zachmorr/IMX6ULL-Dev-Board/Keychain.kicad_pcb

## KiCad design Keychain.kicad_pcb (2021-06-18)

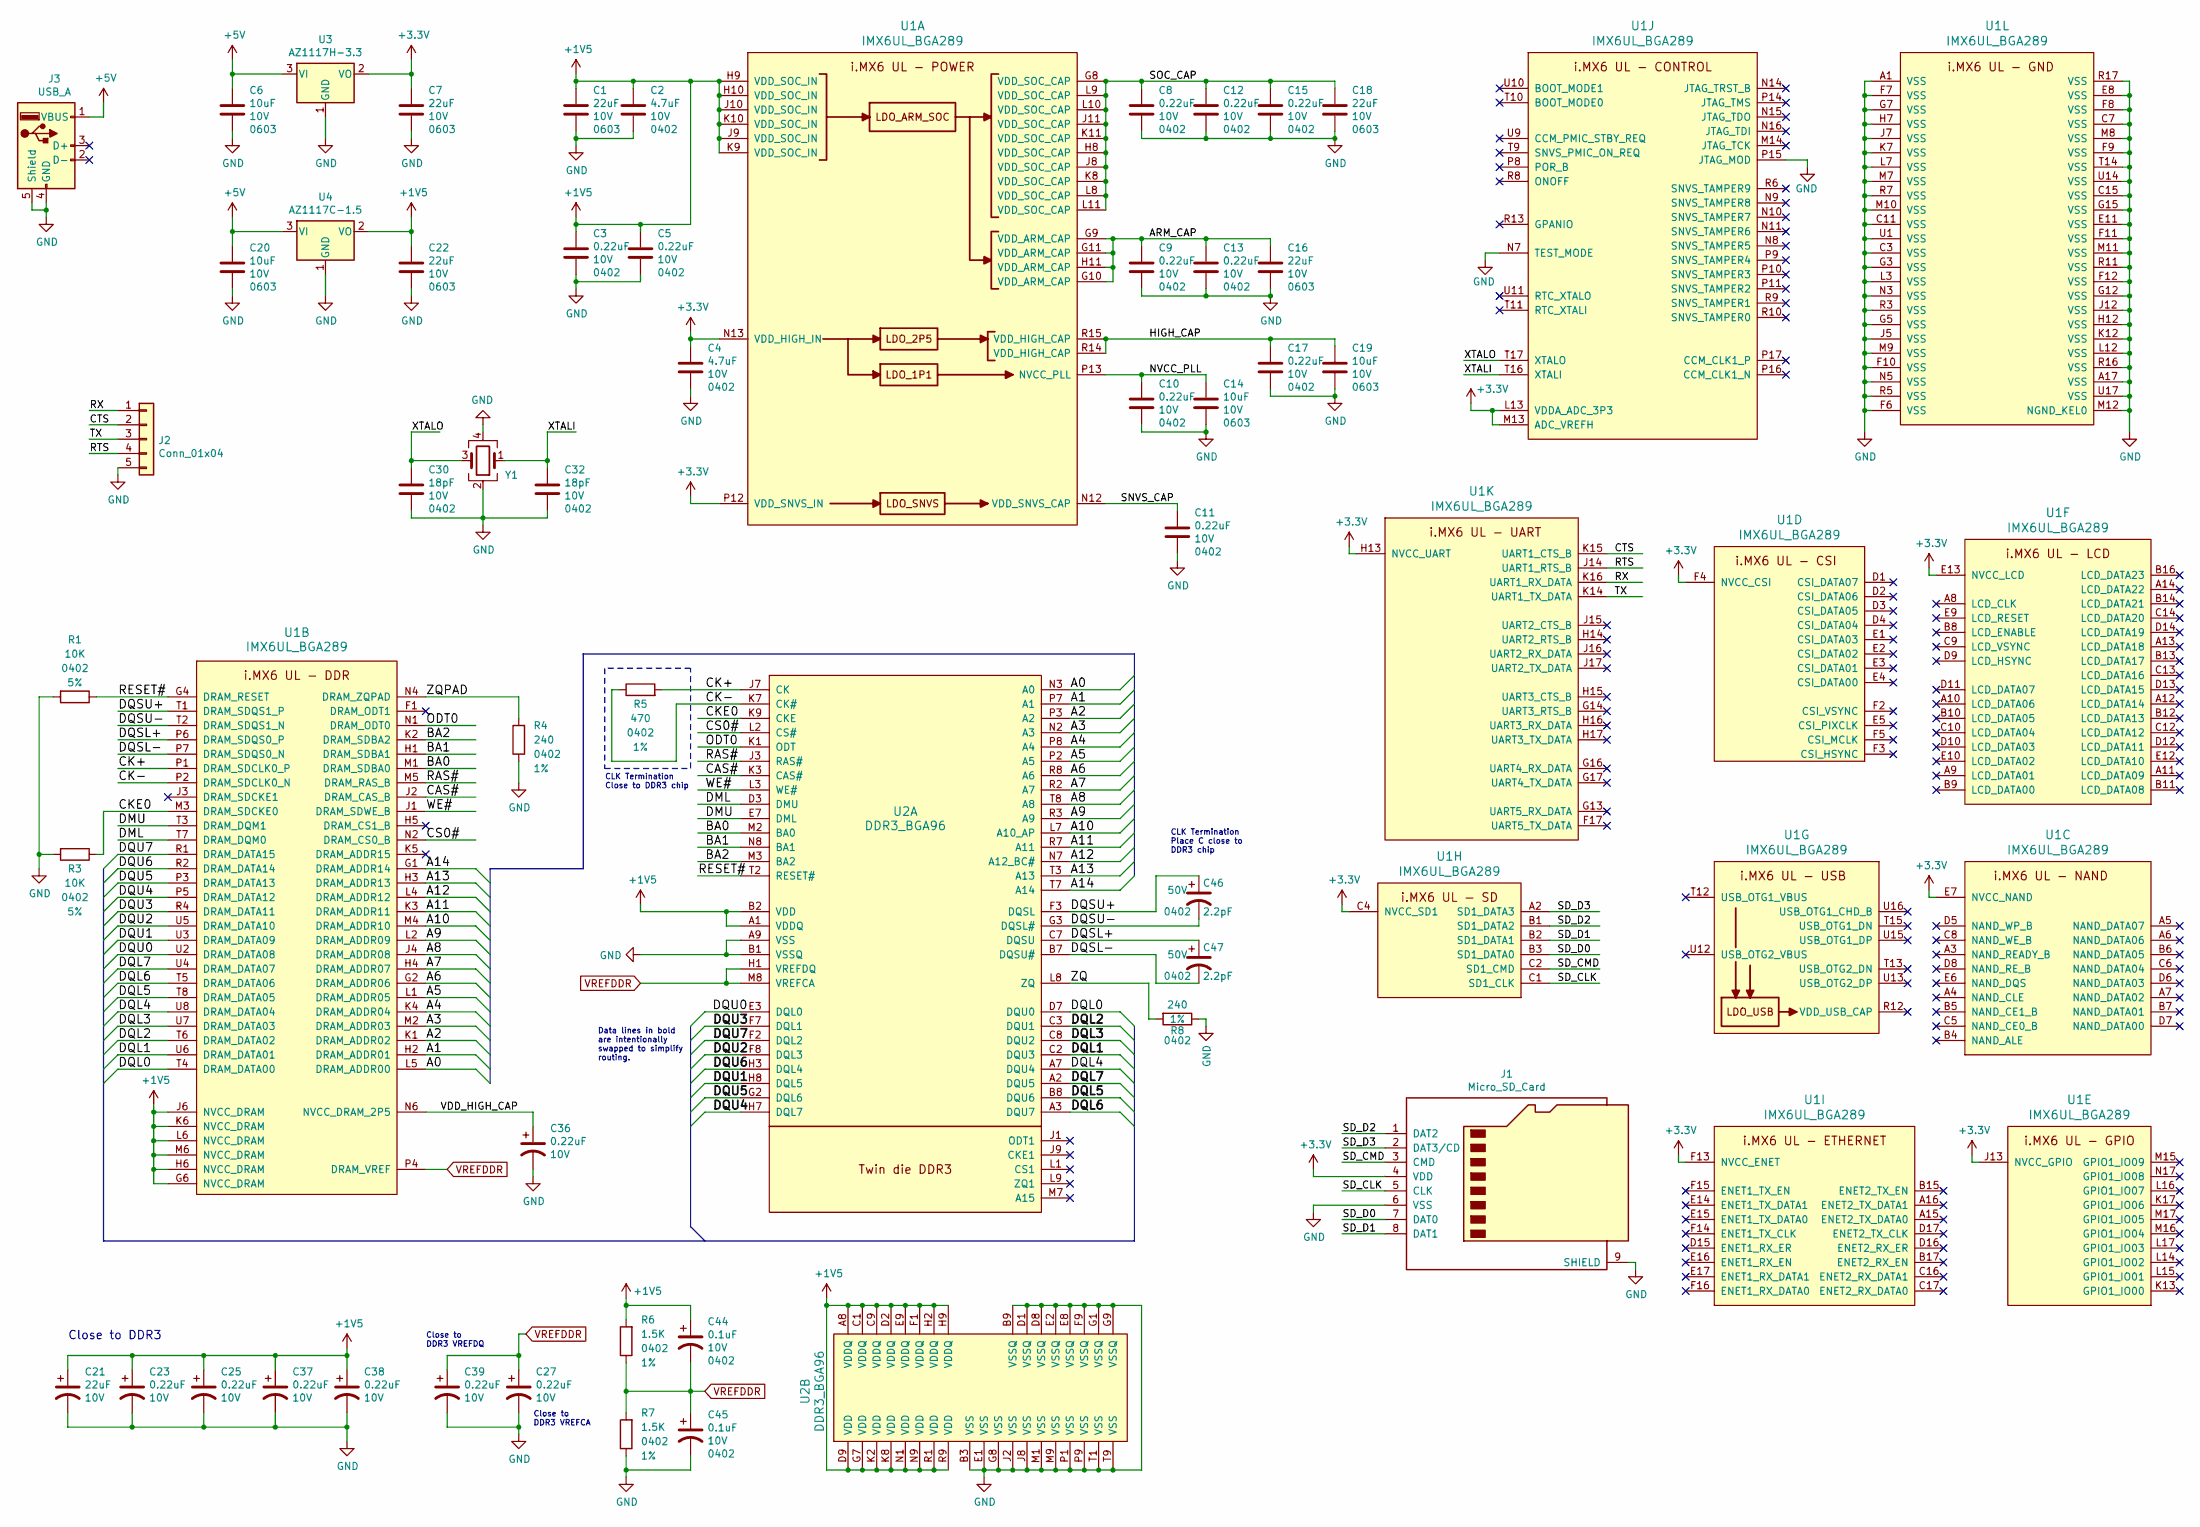
[picture p1: schematic Keychain.sch]

Parts:
C1, C7, C16, C18, C21, C22: 22uF; C_0603_1608Metric; Voltage 10V; LCSC C59461
C2, C4: 4.7uF; C_0402_1005Metric; Voltage 10V; LCSC C23733
C3, C5, C8, C9, C10, C11, C12, C13, C15, C17, C23, C25, C27, C36, C37, C38, C39: 0.22uF; C_0402_1005Metric; Voltage 10V; LCSC C16772
C6, C14, C19, C20: 10uF; C_0603_1608Metric; Voltage 10V; LCSC C15525
C30, C32: 18pF; C_0402_1005Metric; Voltage 10V; LCSC C1549
C44, C45: 0.1uF; C_0402_1005Metric; Voltage 10V; LCSC C1525
C46, C47: 2.2pF; C_0402_1005Metric; Voltage 50V; LCSC C1559
J1: Micro_SD_Card; microSD_HC_Molex_104031-0811
J2: Conn_01x04; PinHeader_1x05_P2.54mm_Vertical
J3: USB_A; USB_A_Molex_67643_Horizontal
R1, R3: 10K; R_0402_1005Metric; Tolerance 5%; LCSC C25744
R4, R8: 240; R_0402_1005Metric; Tolerance 1%; LCSC C25094
R5: 470; R_0402_1005Metric; Tolerance 1%; LCSC C25792
R6, R7: 1.5K; R_0402_1005Metric; Tolerance 1%; LCSC C25867
U1: IMX6UL_BGA289; LCSC C394784
U2: DDR3_BGA96; LCSC C36513
U3: AZ1117H-3.3; SOT-223; LCSC C92517
U4: AZ1117C-1.5; SOT-223; LCSC C92108
Y1: Crystal_GND24; Crystal_SMD_3225-4Pin_3.2x2.5mm; LCSC C91744

Connections:
+1V5: C1.1, C2.1, C3.1, C5.1, C21.1, C22.1, C23.1, C25.1, C37.1, C38.1, C44.1, R6.2, U1.G6 (NVCC_DRAM), U1.H6 (NVCC_DRAM), U1.H9 (VDD_SOC_IN), U1.H10 (VDD_SOC_IN), U1.J6 (NVCC_DRAM), U1.J9 (VDD_SOC_IN), U1.J10 (VDD_SOC_IN), U1.K6 (NVCC_DRAM), U1.K9 (VDD_SOC_IN), U1.K10 (VDD_SOC_IN), U1.L6 (NVCC_DRAM), U1.M6 (NVCC_DRAM), U2.A1 (VDDQ), U2.A8 (VDDQ), U2.B2 (VDD), U2.C1 (VDDQ), U2.C9 (VDDQ), U2.D2 (VDDQ), U2.D9 (VDD), U2.E9 (VDDQ), U2.F1 (VDDQ), U2.G7 (VDD), U2.H2 (VDDQ), U2.H9 (VDDQ), U2.K2 (VDD), U2.K8 (VDD), U2.N1 (VDD), U2.N9 (VDD), U2.R1 (VDD), U2.R9 (VDD), U4.2 (VO)
+3V3: C4.1, C7.1, J1.4 (VDD), U1.C4 (NVCC_SD1), U1.E7 (NVCC_NAND), U1.E13 (NVCC_LCD), U1.F4 (NVCC_CSI), U1.F13 (NVCC_ENET), U1.H13 (NVCC_UART), U1.J13 (NVCC_GPIO), U1.L13 (VDDA_ADC_3P3), U1.M13 (ADC_VREFH), U1.N13 (VDD_HIGH_IN), U1.P12 (VDD_SNVS_IN), U3.2 (VO)
+5V: C6.1, C20.1, J3.1 (VBUS), U3.3 (VI), U4.3 (VI)
/A0: U1.L5 (DRAM_ADDR00), U2.N3 (A0)
/A1: U1.H2 (DRAM_ADDR01), U2.P7 (A1)
/A2: U1.K1 (DRAM_ADDR02), U2.P3 (A2)
/A3: U1.M2 (DRAM_ADDR03), U2.N2 (A3)
/A4: U1.K4 (DRAM_ADDR04), U2.P8 (A4)
/A5: U1.L1 (DRAM_ADDR05), U2.P2 (A5)
/A6: U1.G2 (DRAM_ADDR06), U2.R8 (A6)
/A7: U1.H4 (DRAM_ADDR07), U2.R2 (A7)
/A8: U1.J4 (DRAM_ADDR08), U2.T8 (A8)
/A9: U1.L2 (DRAM_ADDR09), U2.R3 (A9)
/A10: U1.M4 (DRAM_ADDR10), U2.L7 (A10_AP)
/A11: U1.K3 (DRAM_ADDR11), U2.R7 (A11)
/A12: U1.L4 (DRAM_ADDR12), U2.N7 (A12_BC#)
/A13: U1.H3 (DRAM_ADDR13), U2.T3 (A13)
/A14: U1.G1 (DRAM_ADDR14), U2.T7 (A14)
/ARM_CAP: C9.1, C13.1, C16.1, U1.G9 (VDD_ARM_CAP), U1.G10 (VDD_ARM_CAP), U1.G11 (VDD_ARM_CAP), U1.H11 (VDD_ARM_CAP)
/BA0: U1.M1 (DRAM_SDBA0), U2.M2 (BA0)
/BA1: U1.H1 (DRAM_SDBA1), U2.N8 (BA1)
/BA2: U1.K2 (DRAM_SDBA2), U2.M3 (BA2)
/CAS#: U1.J2 (DRAM_CAS_B), U2.K3 (CAS#)
/CK+: R5.2, U1.P1 (DRAM_SDCLK0_P), U2.J7 (CK)
/CK-: R5.1, U1.P2 (DRAM_SDCLK0_N), U2.K7 (CK#)
/CKE0: R3.1, U1.M3 (DRAM_SDCKE0), U2.K9 (CKE)
/CS0#: U1.N2 (DRAM_CS0_B), U2.L2 (CS#)
/CTS: J2.2, U1.K15 (UART1_CTS_B)
/DML: U1.T7 (DRAM_DQM0), U2.D3 (DMU)
/DMU: U1.T3 (DRAM_DQM1), U2.E7 (DML)
/DQL0: U1.T4 (DRAM_DATA00), U2.D7 (DQU0)
/DQL1: U1.U6 (DRAM_DATA01), U2.C2 (DQU3)
/DQL2: U1.T6 (DRAM_DATA02), U2.C3 (DQU1)
/DQL3: U1.U7 (DRAM_DATA03), U2.C8 (DQU2)
/DQL4: U1.U8 (DRAM_DATA04), U2.A7 (DQU4)
/DQL5: U1.T8 (DRAM_DATA05), U2.B8 (DQU6)
/DQL6: U1.T5 (DRAM_DATA06), U2.A3 (DQU7)
/DQL7: U1.U4 (DRAM_DATA07), U2.A2 (DQU5)
/DQSL+: C47.1, U1.P6 (DRAM_SDQS0_P), U2.C7 (DQSU)
/DQSL-: C47.2, U1.P7 (DRAM_SDQS0_N), U2.B7 (DQSU#)
/DQSU+: C46.1, U1.T1 (DRAM_SDQS1_P), U2.F3 (DQSL)
/DQSU-: C46.2, U1.T2 (DRAM_SDQS1_N), U2.G3 (DQSL#)
/DQU0: U1.U2 (DRAM_DATA08), U2.E3 (DQL0)
/DQU1: U1.U3 (DRAM_DATA09), U2.H8 (DQL5)
/DQU2: U1.U5 (DRAM_DATA10), U2.F8 (DQL3)
/DQU3: U1.R4 (DRAM_DATA11), U2.F7 (DQL1)
/DQU4: U1.P5 (DRAM_DATA12), U2.H7 (DQL7)
/DQU5: U1.P3 (DRAM_DATA13), U2.G2 (DQL6)
/DQU6: U1.R2 (DRAM_DATA14), U2.H3 (DQL4)
/DQU7: U1.R1 (DRAM_DATA15), U2.F2 (DQL2)
/HIGH_CAP: C17.1, C19.1, U1.R14 (VDD_HIGH_CAP), U1.R15 (VDD_HIGH_CAP)
/NVCC_PLL: C10.1, C14.1, U1.P13 (NVCC_PLL)
/ODT0: U1.N1 (DRAM_ODT0), U2.K1 (ODT)
/RAS#: U1.M5 (DRAM_RAS_B), U2.J3 (RAS#)
/RESET#: R1.1, U1.G4 (DRAM_RESET), U2.T2 (RESET#)
/RTS: J2.4, U1.J14 (UART1_RTS_B)
/RX: J2.1, U1.K16 (UART1_RX_DATA)
/SD_CLK: J1.5 (CLK), U1.C1 (SD1_CLK)
/SD_CMD: J1.3 (CMD), U1.C2 (SD1_CMD)
/SD_D0: J1.7 (DAT0), U1.B3 (SD1_DATA0)
/SD_D1: J1.8 (DAT1), U1.B2 (SD1_DATA1)
/SD_D2: J1.1 (DAT2), U1.B1 (SD1_DATA2)
/SD_D3: J1.2 (DAT3/CD), U1.A2 (SD1_DATA3)
/SNVS_CAP: C11.1, U1.N12 (VDD_SNVS_CAP)
/SOC_CAP: C8.1, C12.1, C15.1, C18.1, U1.G8 (VDD_SOC_CAP), U1.H8 (VDD_SOC_CAP), U1.J8 (VDD_SOC_CAP), U1.J11 (VDD_SOC_CAP), U1.K8 (VDD_SOC_CAP), U1.K11 (VDD_SOC_CAP), U1.L8 (VDD_SOC_CAP), U1.L9 (VDD_SOC_CAP), U1.L10 (VDD_SOC_CAP), U1.L11 (VDD_SOC_CAP)
/TX: J2.3, U1.K14 (UART1_TX_DATA)
/VDD_HIGH_CAP: C36.1, U1.N6 (NVCC_DRAM_2P5)
/WE#: U1.J1 (DRAM_SDWE_B), U2.L3 (WE#)
/XTALI: C32.1, U1.T16 (XTALI), Y1.1
/XTALO: C30.1, U1.T17 (XTALO), Y1.3
/ZQ: R8.2, U2.L8 (ZQ)
/ZQPAD: R4.2, U1.N4 (DRAM_ZQPAD)
GND: C1.2, C2.2, C3.2, C4.2, C5.2, C6.2, C7.2, C8.2, C9.2, C10.2, C11.2, C12.2, C13.2, C14.2, C15.2, C16.2, C17.2, C18.2, C19.2, C20.2, C21.2, C22.2, C23.2, C25.2, C27.2, C30.2, C32.2, C36.2, C37.2, C38.2, C39.2, C45.2, J1.6 (VSS), J1.9 (SHIELD), J2.5, J3.4 (GND), J3.5 (Shield), R1.2, R3.2, R4.1, R7.1, R8.1, U1.A1 (VSS), U1.A17 (VSS), U1.C3 (VSS), U1.C7 (VSS), U1.C11 (VSS), U1.C15 (VSS), U1.E8 (VSS), U1.E11 (VSS), U1.F6 (VSS), U1.F7 (VSS), U1.F8 (VSS), U1.F9 (VSS), U1.F10 (VSS), U1.F11 (VSS), U1.F12 (VSS), U1.G3 (VSS), U1.G5 (VSS), U1.G7 (VSS), U1.G12 (VSS), U1.G15 (VSS), U1.H7 (VSS), U1.H12 (VSS), U1.J5 (VSS), U1.J7 (VSS), U1.J12 (VSS), U1.K7 (VSS), U1.K12 (VSS), U1.L3 (VSS), U1.L7 (VSS), U1.L12 (VSS), U1.M7 (VSS), U1.M8 (VSS), U1.M9 (VSS), U1.M10 (VSS), U1.M11 (VSS), U1.M12 (NGND_KEL0), U1.N3 (VSS), U1.N5 (VSS), U1.N7 (TEST_MODE), U1.P15 (JTAG_MOD), U1.R3 (VSS), U1.R5 (VSS), U1.R7 (VSS), U1.R11 (VSS), U1.R16 (VSS), U1.R17 (VSS), U1.T14 (VSS), U1.U1 (VSS), U1.U14 (VSS), U1.U17 (VSS), U2.A9 (VSS), U2.B1 (VSSQ), U2.B3 (VSS), U2.B9 (VSSQ), U2.D1 (VSSQ), U2.D8 (VSSQ), U2.E1 (VSS), U2.E2 (VSSQ), U2.E8 (VSSQ), U2.F9 (VSSQ), U2.G1 (VSSQ), U2.G8 (VSS), U2.G9 (VSSQ), U2.J2 (VSS), U2.J8 (VSS), U2.M1 (VSS), U2.M9 (VSS), U2.P1 (VSS), U2.P9 (VSS), U2.T1 (VSS), U2.T9 (VSS), U3.1 (GND), U3.4, U4.1 (GND), U4.4, Y1.2, Y1.4
VREFDDR: C27.1, C39.1, C44.2, C45.1, R6.1, R7.2, U1.P4 (DRAM_VREF), U2.H1 (VREFDQ), U2.M8 (VREFCA)

Notes on the sheet:
CLK Termination Place C close to DDR3 chip
Data lines in bold are intentionally swapped to simplify routing.
CLK Termination Close to DDR3 chip
Close to DDR3
Close to DDR3 VREFCA
Close to DDR3 VREFDQ

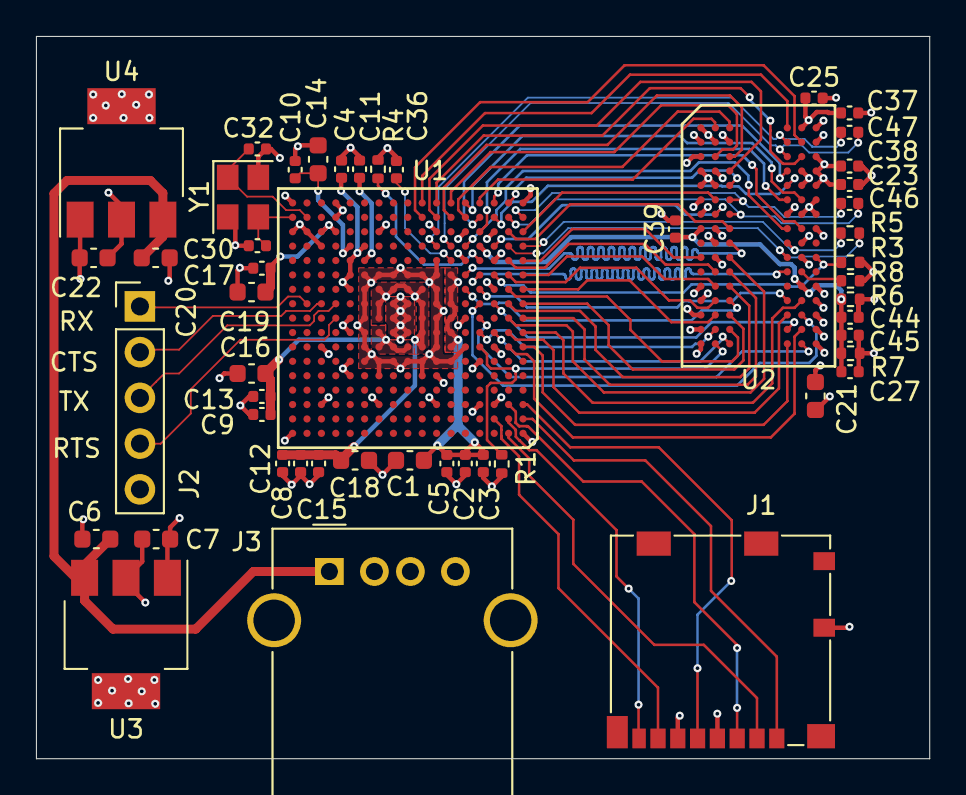
[picture p2: board Keychain.kicad_pcb from above]

Board: 4 copper layers, 49.6 x 40.1 mm, 50 parts (0 on the bottom side), 74 nets.
