zachmorr/IMX6ULL-Dev-Board/(commit log)

2020-11-16 Adding KiCad project
    [CPUPower.sch, DDR.sch, Keychain.kicad_pcb, Keychain.sch, Peripherals.sch]
2020-11-20 DDR nets are connected, now needs length tuning
    [Keychain.kicad_pcb]
2020-11-24 Completed DDR routing & length matching
    [Keychain.kicad_pcb]
2020-11-25 Added some LDO and connectors, still need to finish routing
    [CPUPower.sch, DDR.sch, Keychain.kicad_pcb, Keychain.sch, Peripherals 2.sch, Peripherals.sch]
2020-12-15 Finished first version of board
    [CPUPower.sch, DDR.sch, Keychain.kicad_pcb, Peripherals 2.sch, Peripherals.sch]
2020-12-15 Moved some parts to bottom for easier assembly
    [Keychain-B_Mask.gbr, Keychain-B_Paste.gbr, Keychain-B_SilkS.gbr, Keychain-Bottom.gbr, Keychain-Edge_Cuts.gbr, Keychain-F_Mask.gbr, Keychain-F_Paste.gbr, Keychain-F_SilkS.gbr]
2021-05-14 New layout!
    [CPUPower.sch, DDR.sch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]
2021-06-18 New layout
    [Keychain-B_Cu.gbr, Keychain-B_Mask.gbr, Keychain-B_Paste.gbr, Keychain-B_SilkS.gbr, Keychain-Edge_Cuts.gbr, Keychain-F_Cu.gbr, Keychain-F_Mask.gbr, Keychain-F_Paste.gbr]
